c500g/VigiPoule_v4/photo_vigiPoule.jpeg

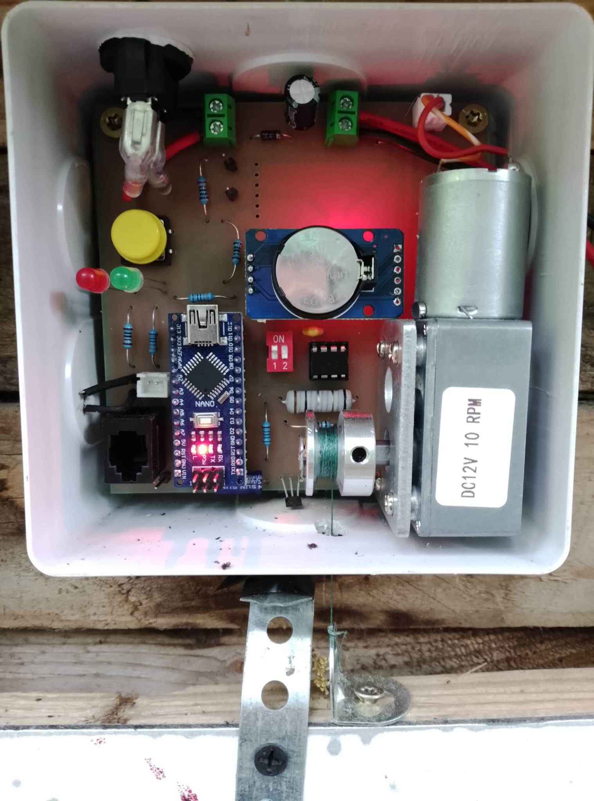
photo_vigiPoule.jpeg
