c500g/VigiPoule_v4/schema_VigiPoule_v4.pdf

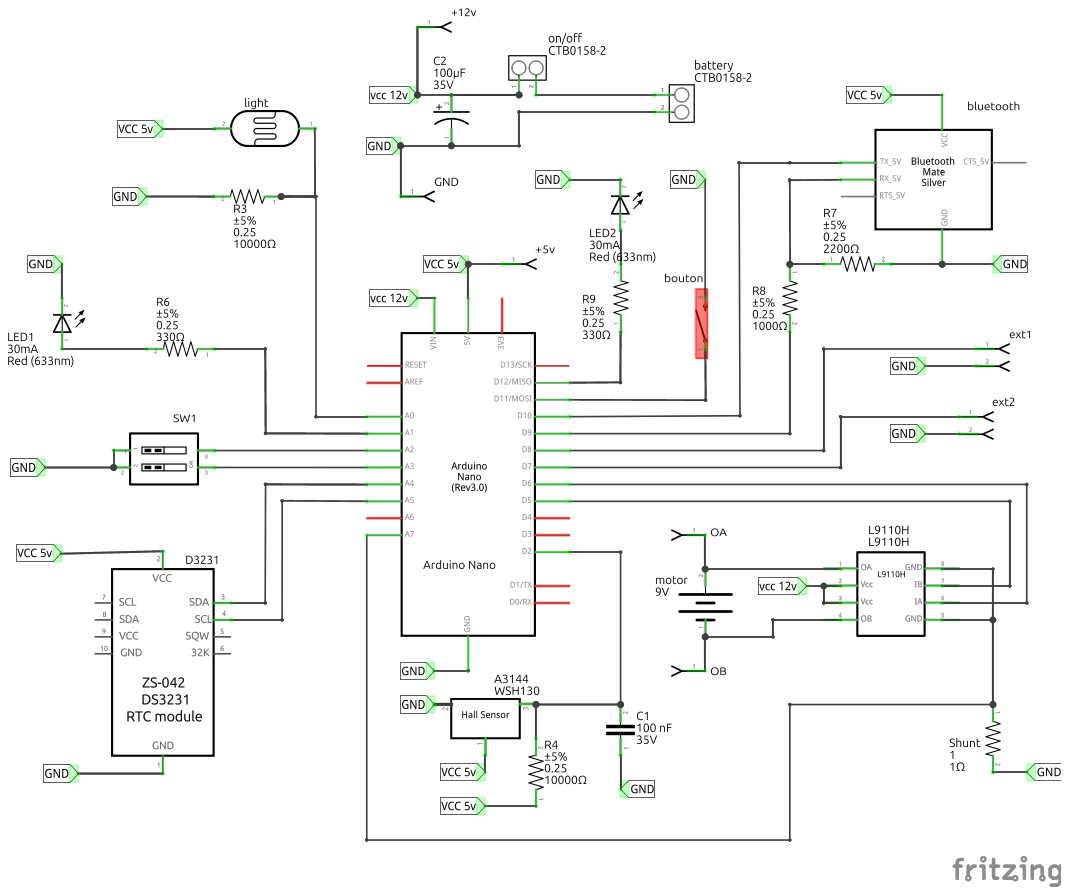
[picture p2: page 1]
