c500g/VigiPoule_v4/pcb_VigiPoule_v4.pdf

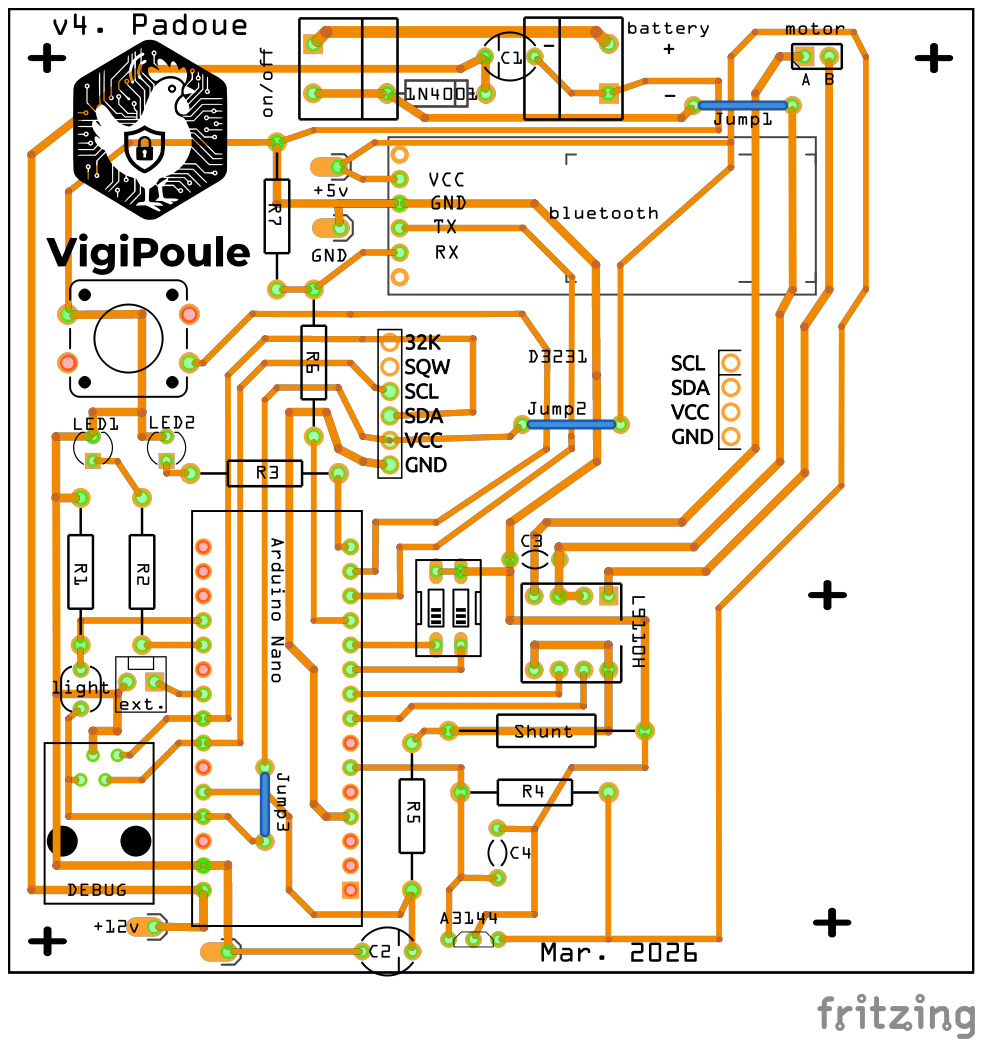
[picture p3: page 1]
